IsmailS-712/BalanceBug/Designs/back_v2.png

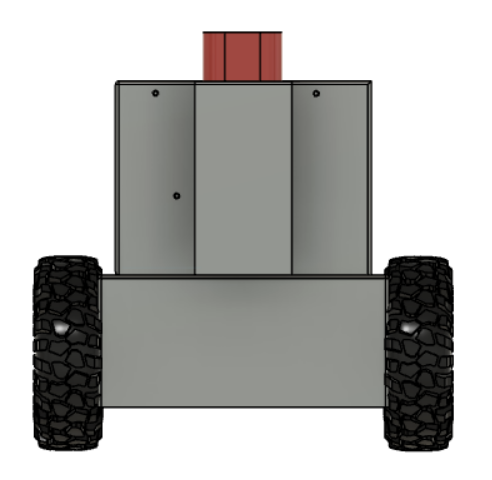
Designs/back_v2.png
