IsmailS-712/BalanceBug/Designs/bottom_v2.png

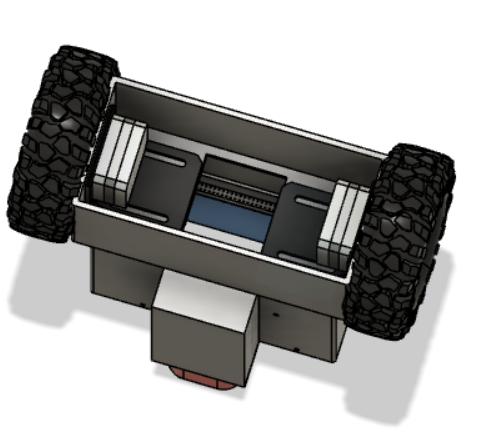
Designs/bottom_v2.png
