IsmailS-712/BalanceBug/Designs/bottom_v2_closed.png

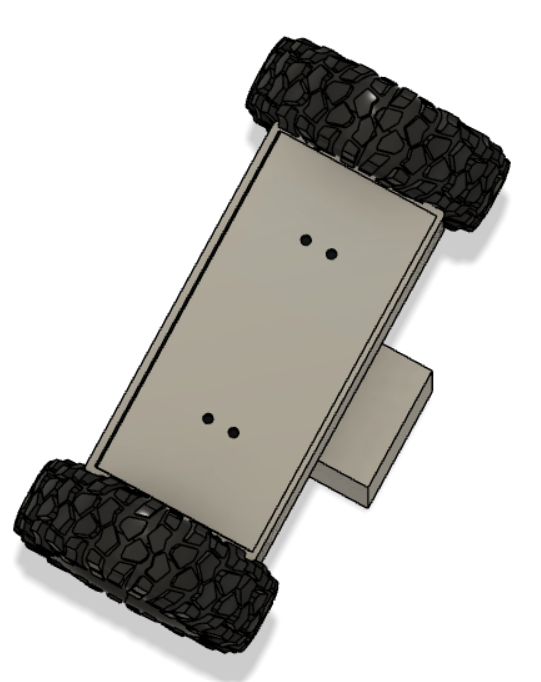
Designs/bottom_v2_closed.png
