IsmailS-712/BalanceBug/Designs/front_v2.png

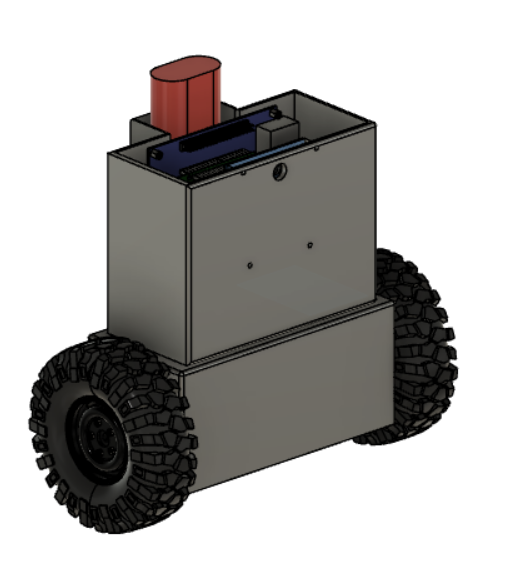
Designs/front_v2.png
