IsmailS-712/BalanceBug/Designs/side_v2.png

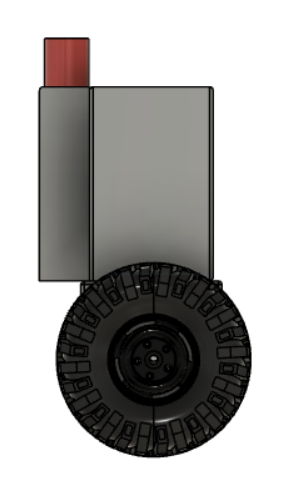
Designs/side_v2.png
