IsmailS-712/BalanceBug/Designs/top_v2.png

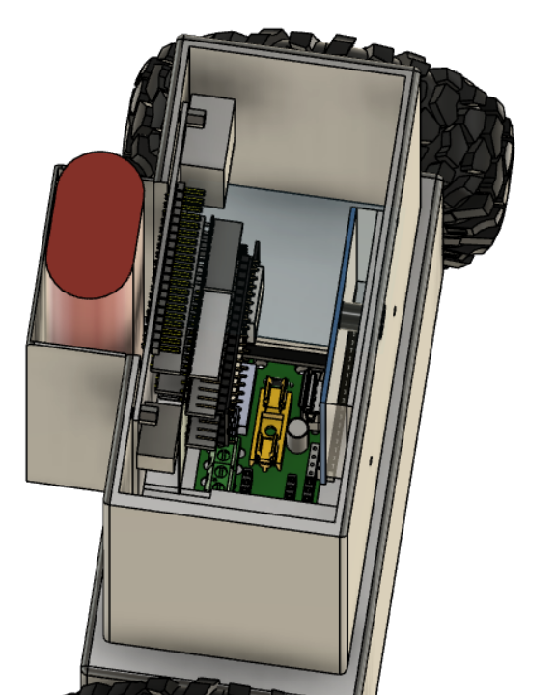
Designs/top_v2.png
