IsmailS-712/BalanceBug/TakenFromEEERepo/A4988-current_limiting_potentiometer.jpg

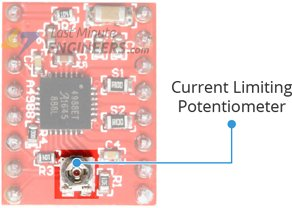
TakenFromEEERepo/A4988-current_limiting_potentiometer.jpg
