IsmailS-712/BalanceBug/TakenFromEEERepo/A4988_driver_pinout.png

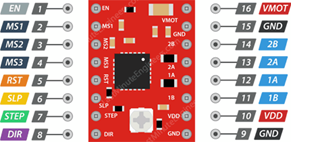
TakenFromEEERepo/A4988_driver_pinout.png
