IsmailS-712/BalanceBug/TakenFromEEERepo/MPU6050-pinout.png

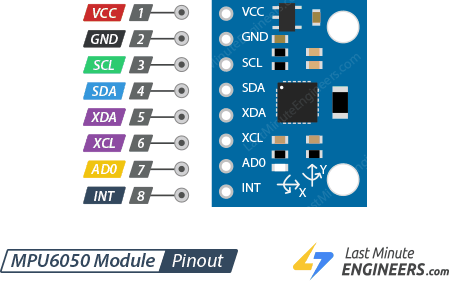
TakenFromEEERepo/MPU6050-pinout.png
