IsmailS-712/BalanceBug/TakenFromEEERepo/MPU6050.jpg

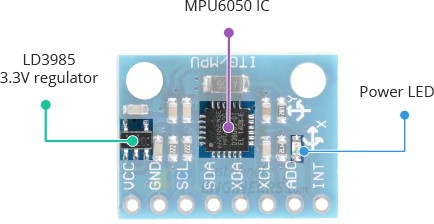
TakenFromEEERepo/MPU6050.jpg
