IsmailS-712/BalanceBug/TakenFromEEERepo/NEMA17.jpg

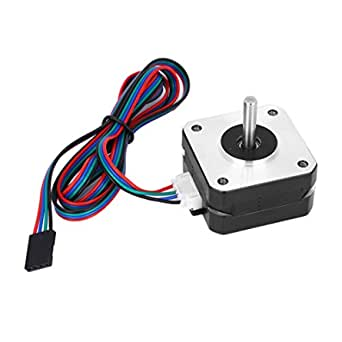
TakenFromEEERepo/NEMA17.jpg
