IsmailS-712/BalanceBug/Designs/bottom_box.stl

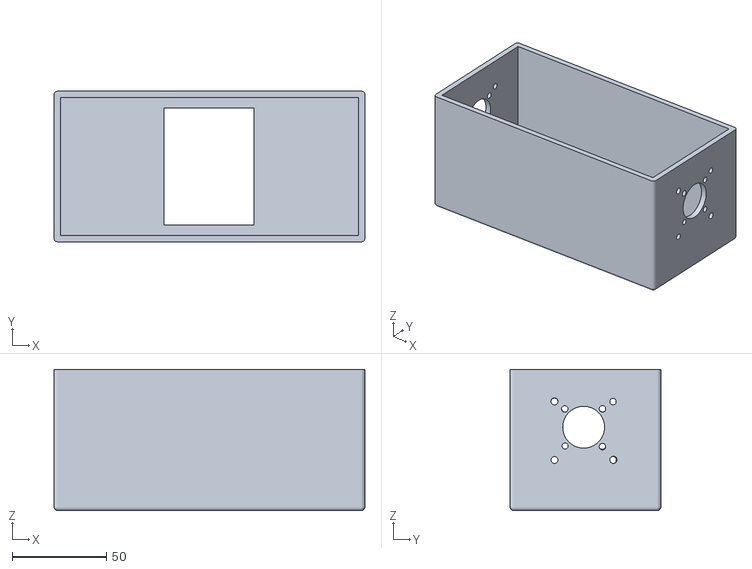
[picture p38: CAD file, 2023-06-04]
Designs/bottom_box.stl
165.0 x 80.0 x 75.0
