IsmailS-712/BalanceBug/TakenFromEEERepo/mechanical/chassis_v2.dxf

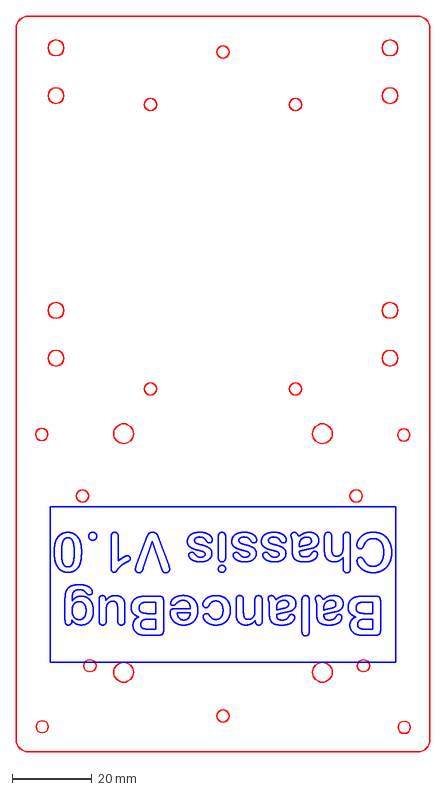
[picture p39: CAD file, 2023-05-23]
TakenFromEEERepo/mechanical/chassis_v2.dxf
104.0 x 185.0 mm
