IsmailS-712/BalanceBug/Designs/top_body.stl

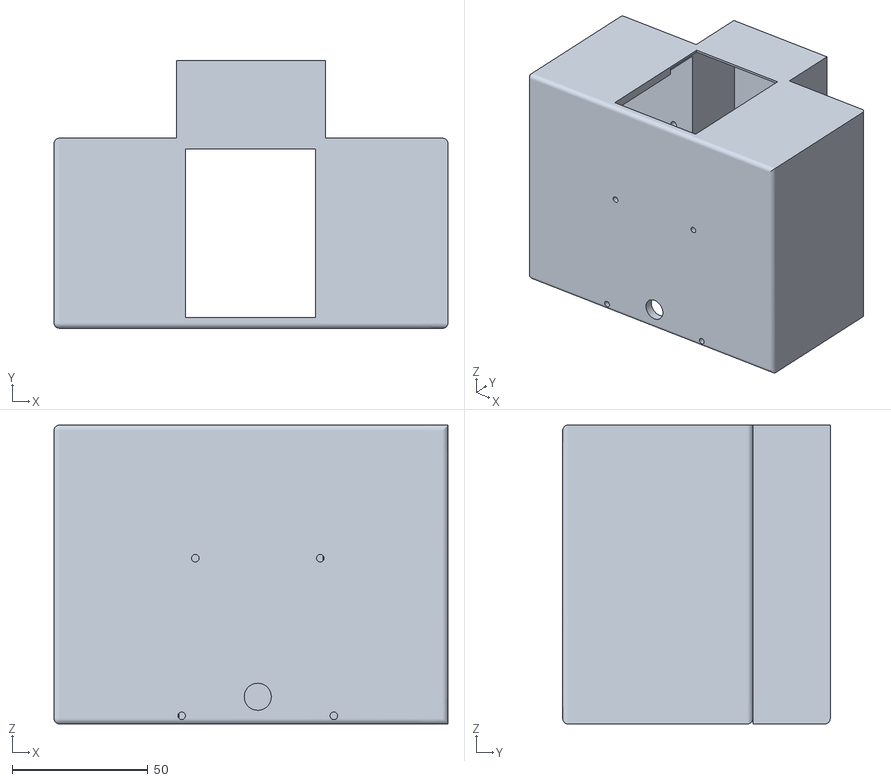
[picture p40: CAD file, 2023-06-04]
Designs/top_body.stl
145.0 x 98.5 x 110.0
