IsmailS-712/BalanceBug/TakenFromEEERepo/mechanical/Bracket_R.STL

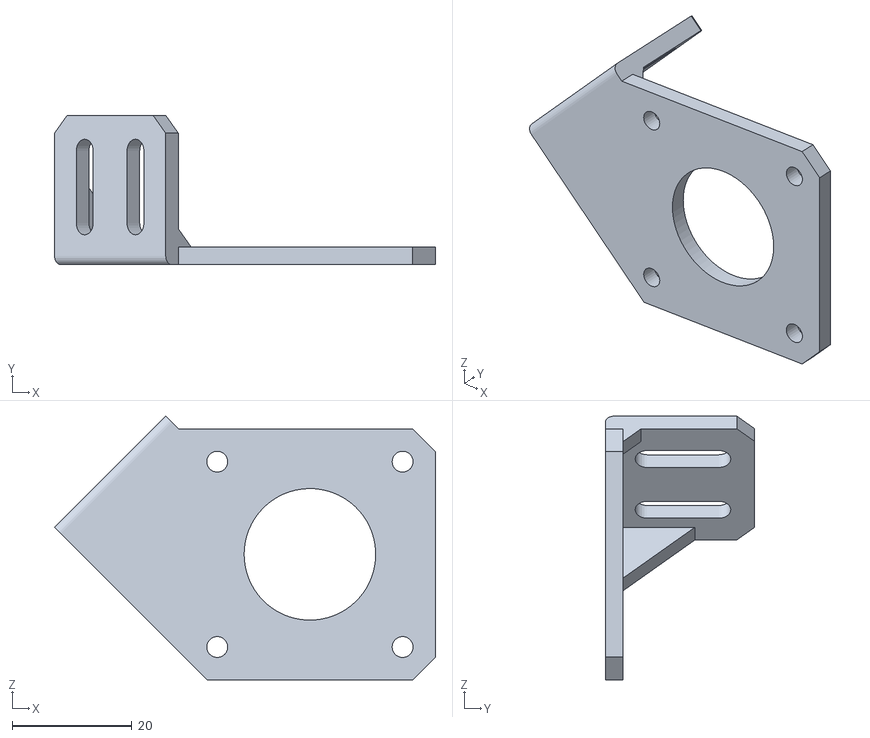
[picture p41: CAD file, 2023-05-23]
TakenFromEEERepo/mechanical/Bracket_R.STL
63.7 x 25.0 x 44.1
