IsmailS-712/BalanceBug/Designs/Lid.stl

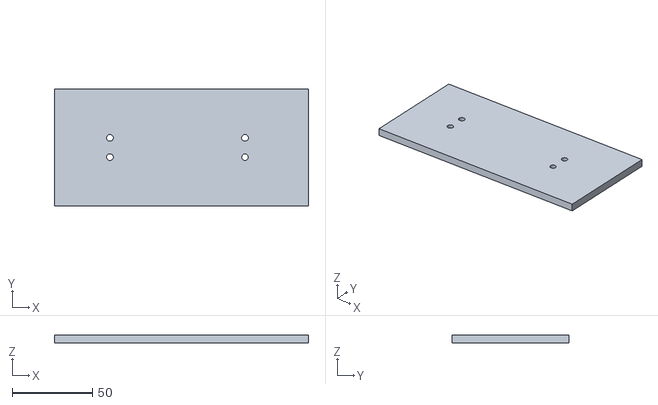
[picture p42: CAD file, 2023-06-04]
Designs/Lid.stl
158.0 x 73.0 x 5.00
