IsmailS-712/BalanceBug/TakenFromEEERepo/mechanical/balance_leg_v2.STL

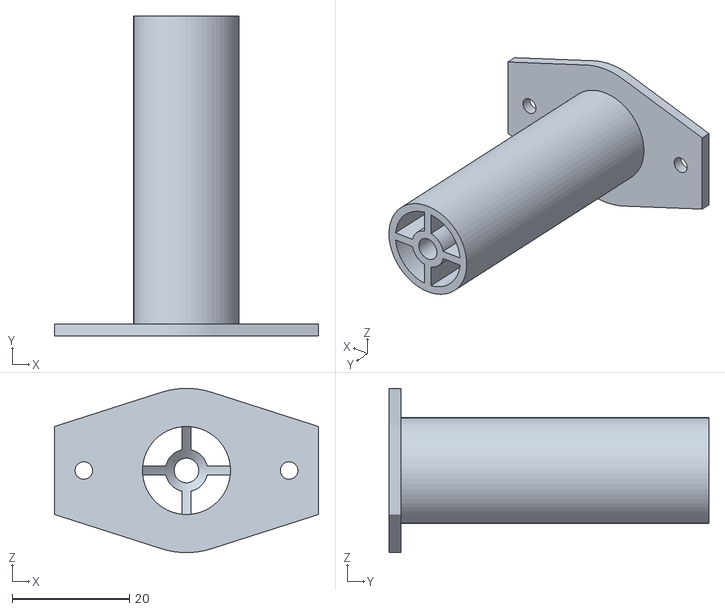
[picture p43: CAD file, 2023-05-23]
TakenFromEEERepo/mechanical/balance_leg_v2.STL
45.0 x 54.5 x 28.0
