IsmailS-712/BalanceBug/Designs/Mounting Bracket for Nema 17 Stepper Motor v1.stl

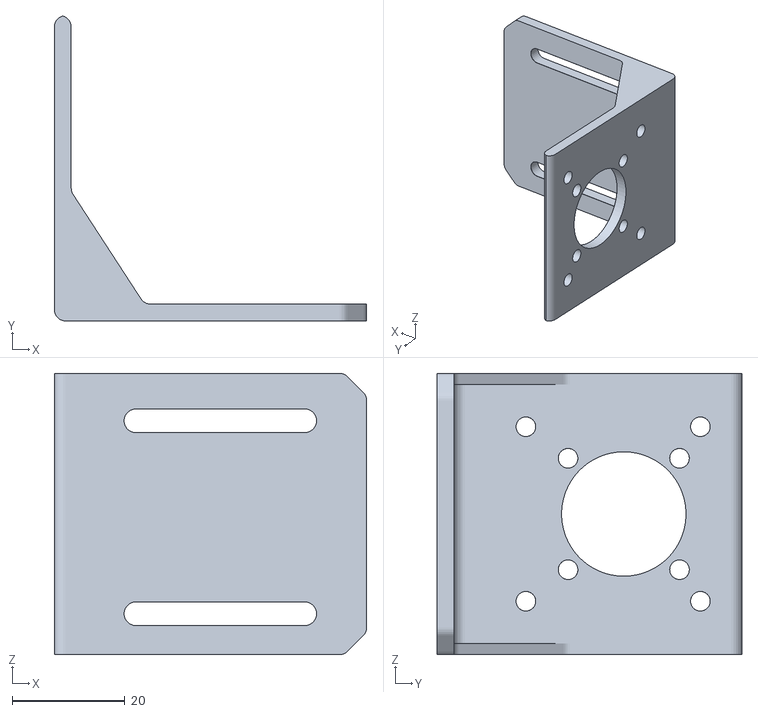
[picture p44: CAD file, 2023-06-04]
Designs/Mounting Bracket for Nema 17 Stepper Motor v1.stl
55.5 x 54.2 x 50.0
