IsmailS-712/BalanceBug/(list of files, cad)

Other CAD files:
TakenFromEEERepo/mechanical/Bracket_L.STL
