IsmailS-712/BalanceBug/Control/PID Controller tuning.xlsx

Sheet: Controller
 | Reference Pitch (deg): | 10
Proporional | Kp: | 14
Integral | Ki: | 10
Derivative | Kd: | 2

Sheet: Simulation Data
time (s) | Reference Signal | Pitch Angle | dotpitch | dotdotpitch | u(t) | e(t) | dote(t) | inte(t) |  | 0.1
0.01 | 0 | 0 | 0 | 0 | 0 | 0 | 0 | 0 | 0 | 0
0.02 | 0 | 0 | 0 | 0 | 0 | 0 | 0 | 0 |  | 0
0.03 | 0 | 0 | 0 | 0 | 0 | 0 | 0 | 0 |  | 0
0.04 | 0 | 0 | 0 | 0 | 0 | 0 | 0 | 0 |  | 0
0.05 | 0 | 0 | 0 | 0 | 0 | 0 | 0 | 0 |  | 0
0.06 | 0 | 0 | 0 | 0 | 0 | 0 | 0 | 0 |  | 0
0.07 | 0 | 0 | 0 | 0 | 0 | 0 | 0 | 0 |  | 0
0.08 | 0 | 0 | 0 | 0 | 0 | 0 | 0 | 0 |  | 0
0.09 | 0 | 0 | 0 | 0 | 0 | 0 | 0 | 0 |  | 0
0.1 | 0 | 0 | 0 | 0 | 0 | 0 | 0 | 0 |  | 0
0.11 | 0 | 0 | 0 | 0 | 0 | 0 | 0 | 0 |  | 0
0.12 | 0 | 0 | 0 | 0 | 0 | 0 | 0 | 0 |  | 0
0.13 | 0 | 0 | 0 | 0 | 0 | 0 | 0 | 0 |  | 0
0.14 | 0 | 0 | 0 | 0 | 0 | 0 | 0 | 0 |  | 0
0.15 | 0 | 0 | 0 | 0 | 0 | 0 | 0 | 0 |  | 0
0.16 | 0 | 0 | 0 | 0 | 0 | 0 | 0 | 0 |  | 0
0.17 | 0 | 0 | 0 | 0 | 0 | 0 | 0 | 0 |  | 0
0.18 | 0 | 0 | 0 | 0 | 0 | 0 | 0 | 0 |  | 0
0.19 | 0 | 0 | 0 | 0 | 0 | 0 | 0 | 0 |  | 0
0.2 | 0 | 0 | 0 | 0 | 0 | 0 | 0 | 0 |  | 0
0.21 | 0 | 0 | 0 | 0 | 0 | 0 | 0 | 0 |  | 0
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
