IsmailS-712/BalanceBug/(commit log)

2023-05-23 copied from og repo
    [Bracket_L.STL, Bracket_R.STL, balance_leg_v2.STL, chassis_v2.dxf]
2023-05-25 feat: records current and last updated timestamp
2023-06-01 feat(test): maze trace
2023-06-08 Add files via upload
    Micropython code for the Buck LED drivers
2023-06-14 uart in progress
2023-06-14 sensor fusion
2023-06-15 feat: add reset button
2023-06-15 Rename Energy System/MPPT/Code/LED_Driver_Buck_Fixed.py to Energy System/LED Driver/LED_Driver_Buck_Fixed.py
2023-06-15 Rename Energy System/MPPT/Code/LED_Driver_PID_Control.py to Energy System/LED Drivers/LED_Driver_PID_Control.py
2023-06-16 PID Controller tuning model created by Felipe Mendes
    [PID Controller tuning.xlsx]
2023-06-17 Update LED_Driver_PID_Control.py
    Removed unnecessary print statements
2023-06-21 http driver code
2023-06-22 began integration - needs motor code
2023-06-22 Create LED_Drivers_Integrated_With_WiFi.py
    added wifi capabilities to the led driver code
2023-06-22 Update Integrated_Code.ino
    Removed Serial.print from when the directions are called as useless
2023-06-22 Update LED_Drivers_Integrated_With_WiFi.py
    added timer so every 2 second new power data is sent to the server
2023-06-23 integrated -> needs motor debugging
2023-06-23 Create motor_code_with_positon_data
2023-06-24 Final PID controller code for stabilisation of rover in vertical mode
